MarcFinns/Active-Crossover-2025/Pictures/IMG_0705.jpeg

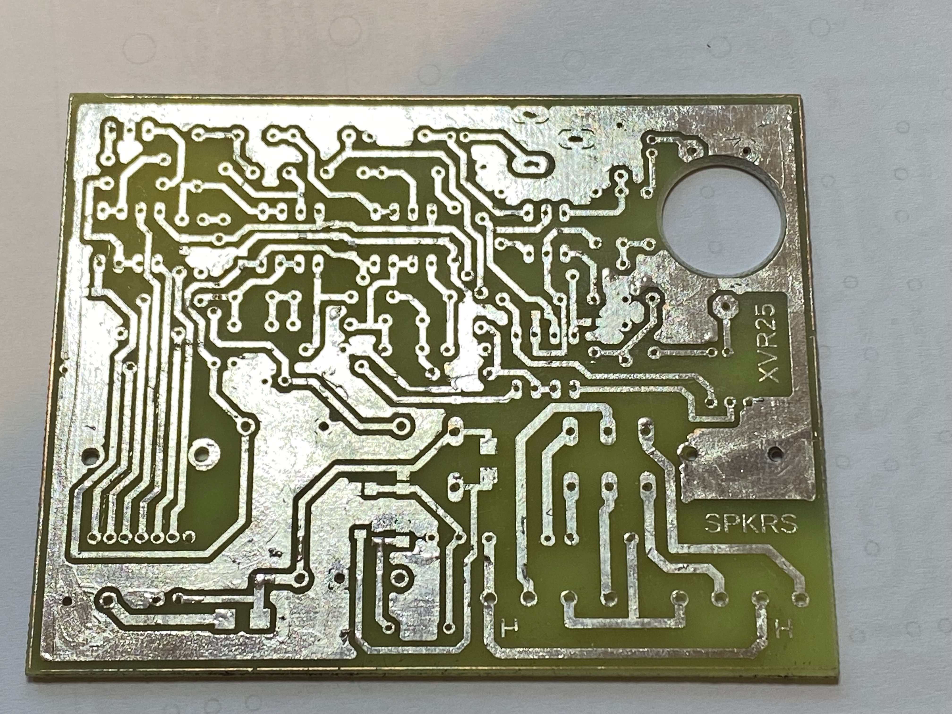
Pictures/IMG_0705.jpeg
