MarcFinns/Active-Crossover-2025/Pictures/IMG_1233.jpeg

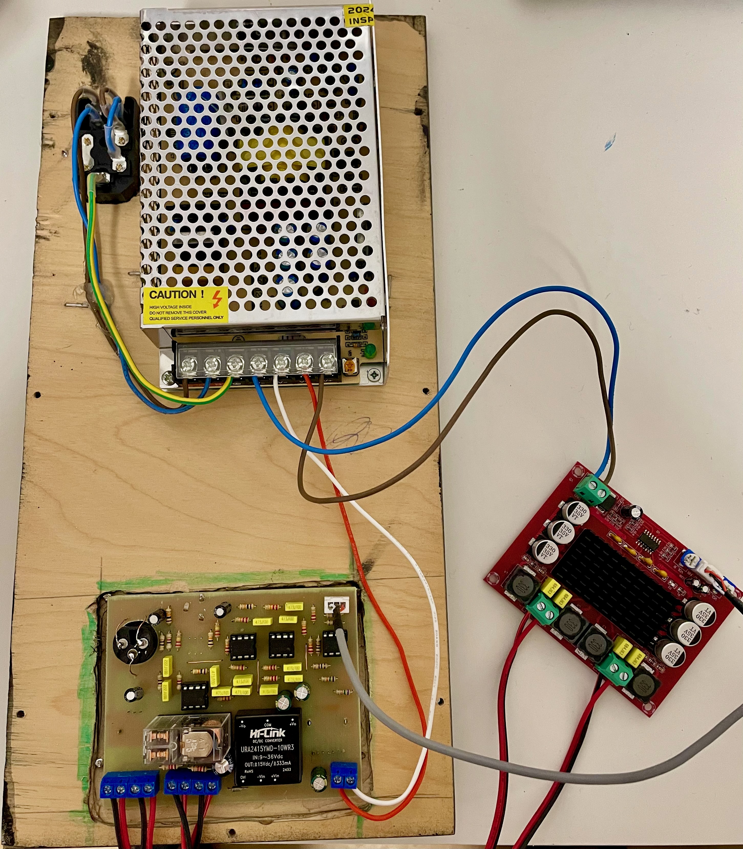
Pictures/IMG_1233.jpeg
