MarcFinns/Active-Crossover-2025/README.md

## Active crossover and anti-pop

Used to transform old speakers into active monitors together with a TPA3116 stereo amp board and a 24V power supply from Aliexpress
