MarcFinns/Active-Crossover-2025/Plate.pptx

LINE IN

XLR IN

100 W BI-AMP

INPUT SELECT

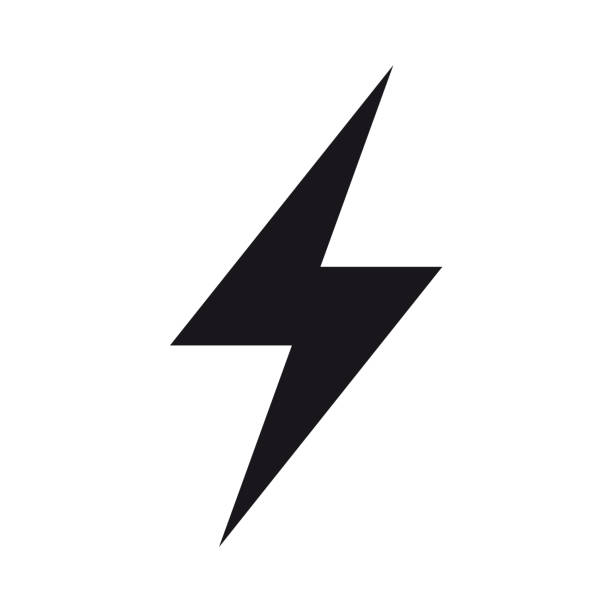
[picture p3: figure]
22,200+ Lightning Logo Stock Illustrations, Royalty-Free ...

LO

HI

VOLUME

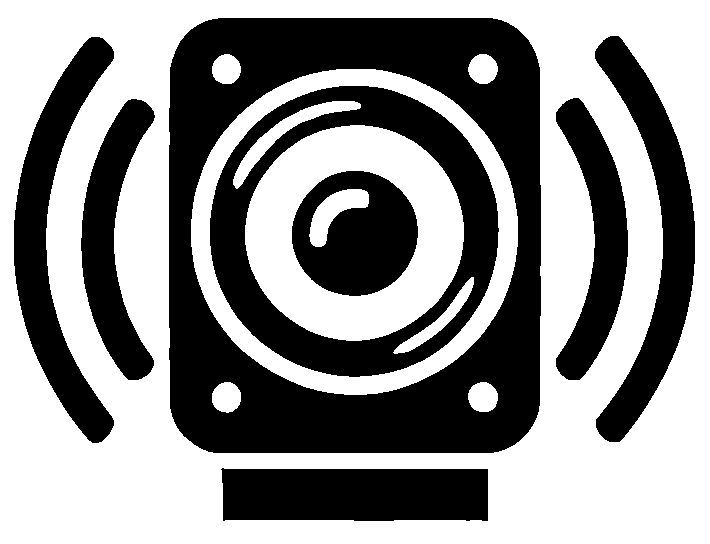
[picture p4: figure]

## Slide 2

100 W BI-AMP

LINE IN

XLR IN

INPUT SELECT

LO

HI

VOLUME
