MarcFinns/Active-Crossover-2025/Pictures/IMG_0700.jpeg

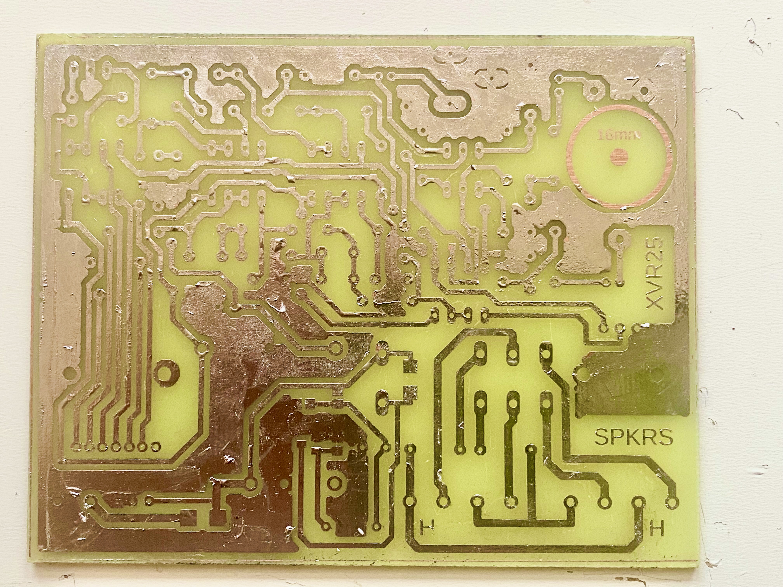
Pictures/IMG_0700.jpeg
