MarcFinns/Active-Crossover-2025/Pictures/IMG_0706.jpeg

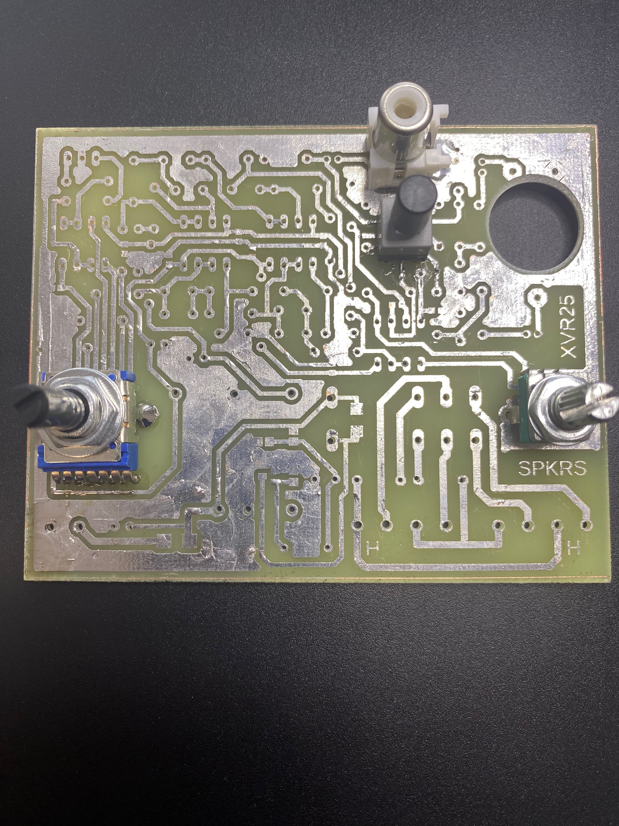
Pictures/IMG_0706.jpeg
