MarcFinns/Active-Crossover-2025/Pictures/IMG_0707.jpeg

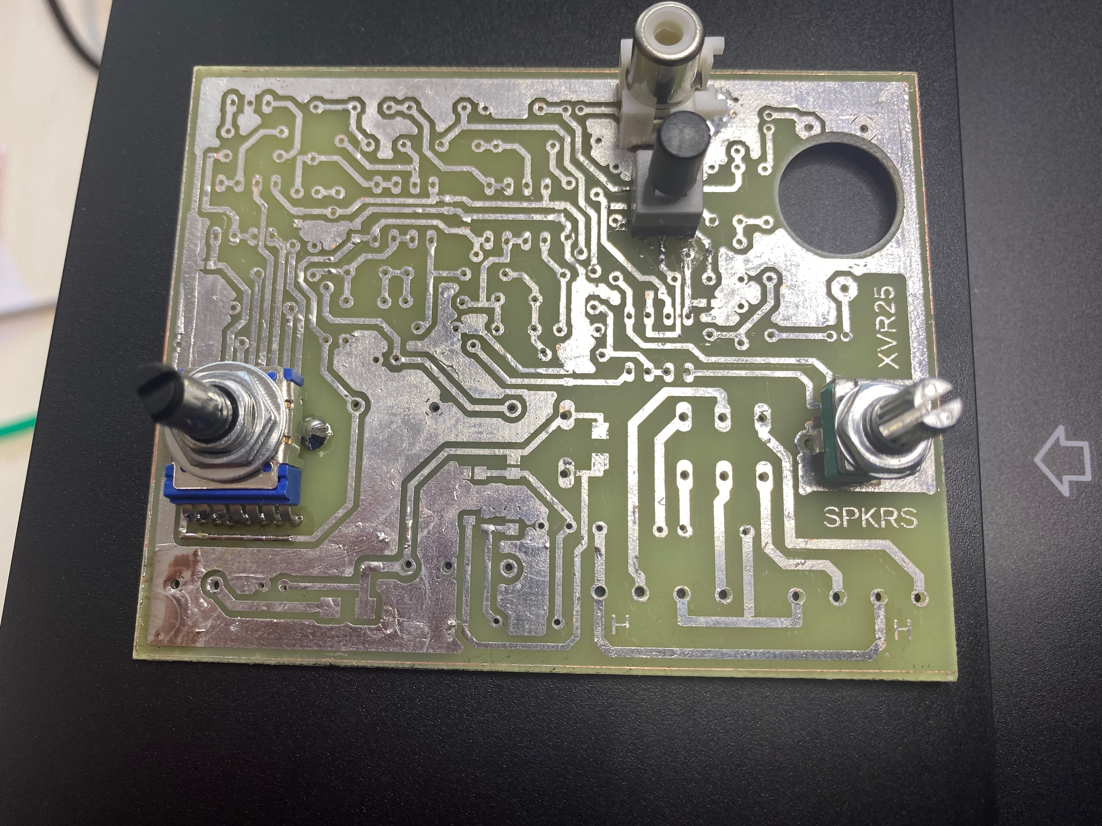
Pictures/IMG_0707.jpeg
