MarcFinns/Active-Crossover-2025/Pictures/IMG_0741.jpeg

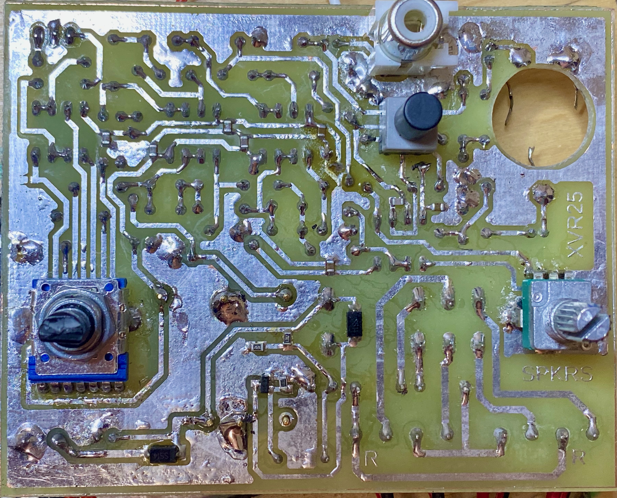
Pictures/IMG_0741.jpeg
