MarcFinns/Active-Crossover-2025/Pictures/IMG_0742.jpeg

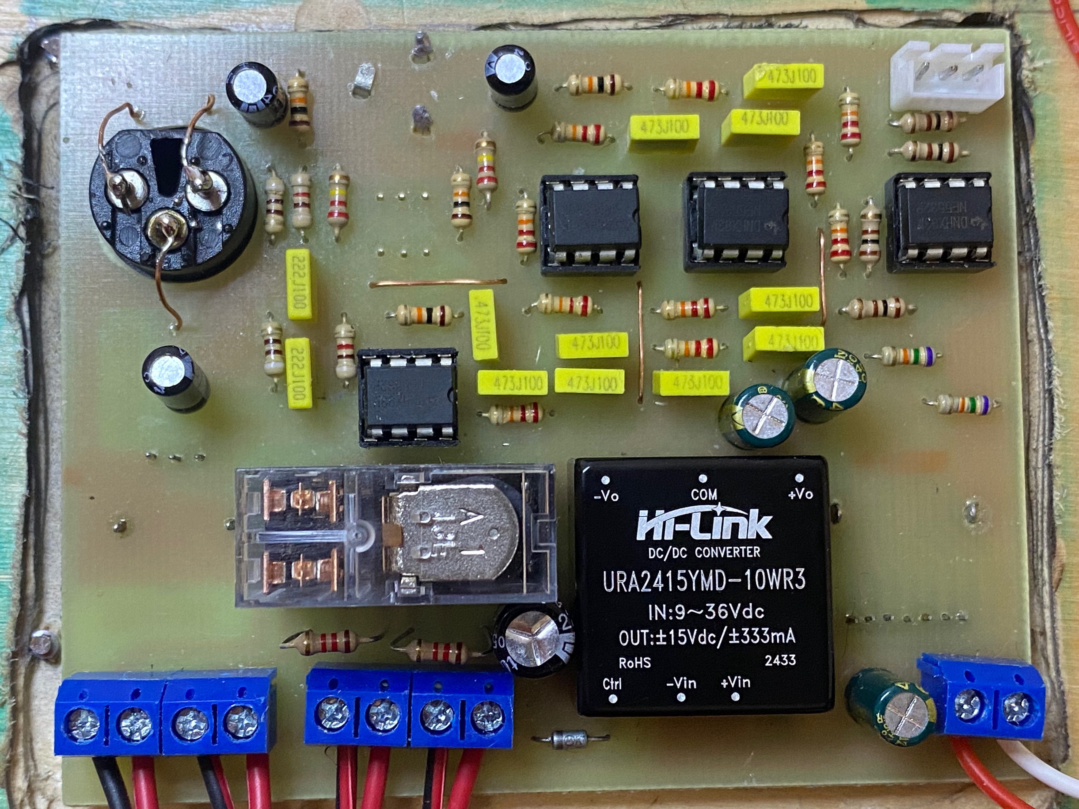
Pictures/IMG_0742.jpeg
