MarcFinns/Active-Crossover-2025/Pictures/IMG_1224.jpeg

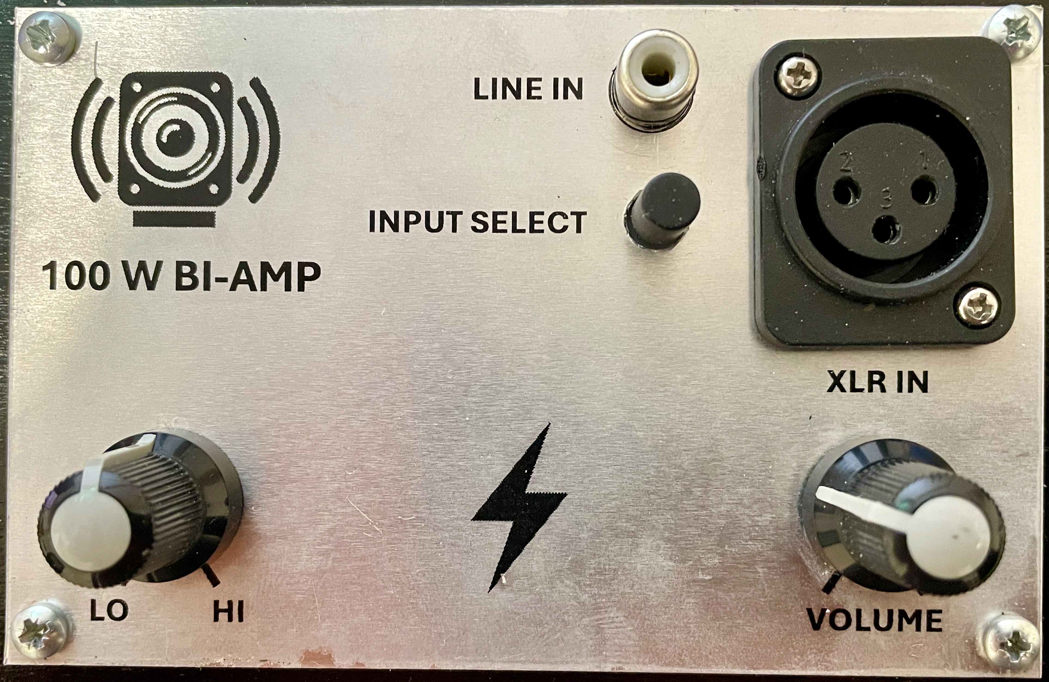
Pictures/IMG_1224.jpeg
