MarcFinns/Active-Crossover-2025/Pictures/IMG_1226.jpeg

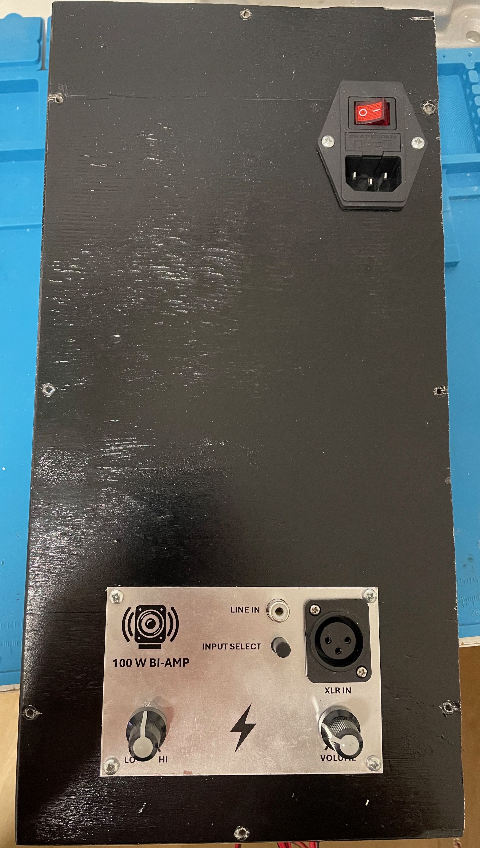
Pictures/IMG_1226.jpeg
