MarcFinns/Active-Crossover-2025/Pictures/IMG_1228.jpeg

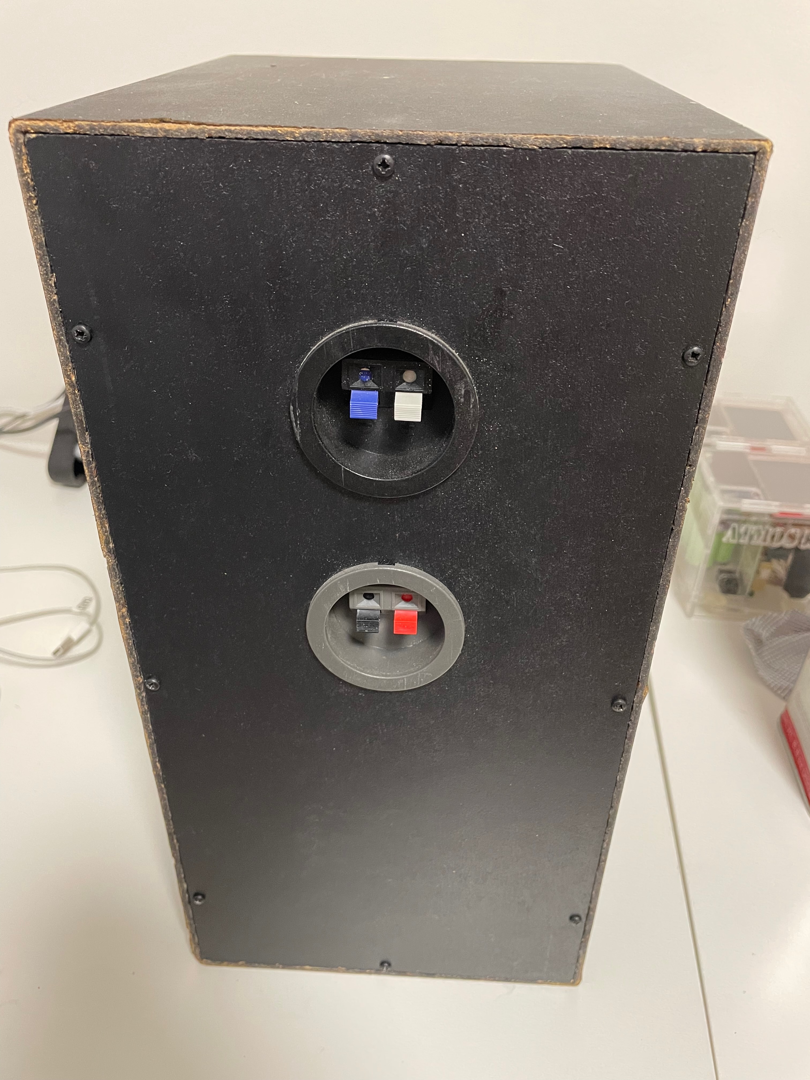
Pictures/IMG_1228.jpeg
