MarcFinns/Active-Crossover-2025/Pictures/IMG_1229.jpeg

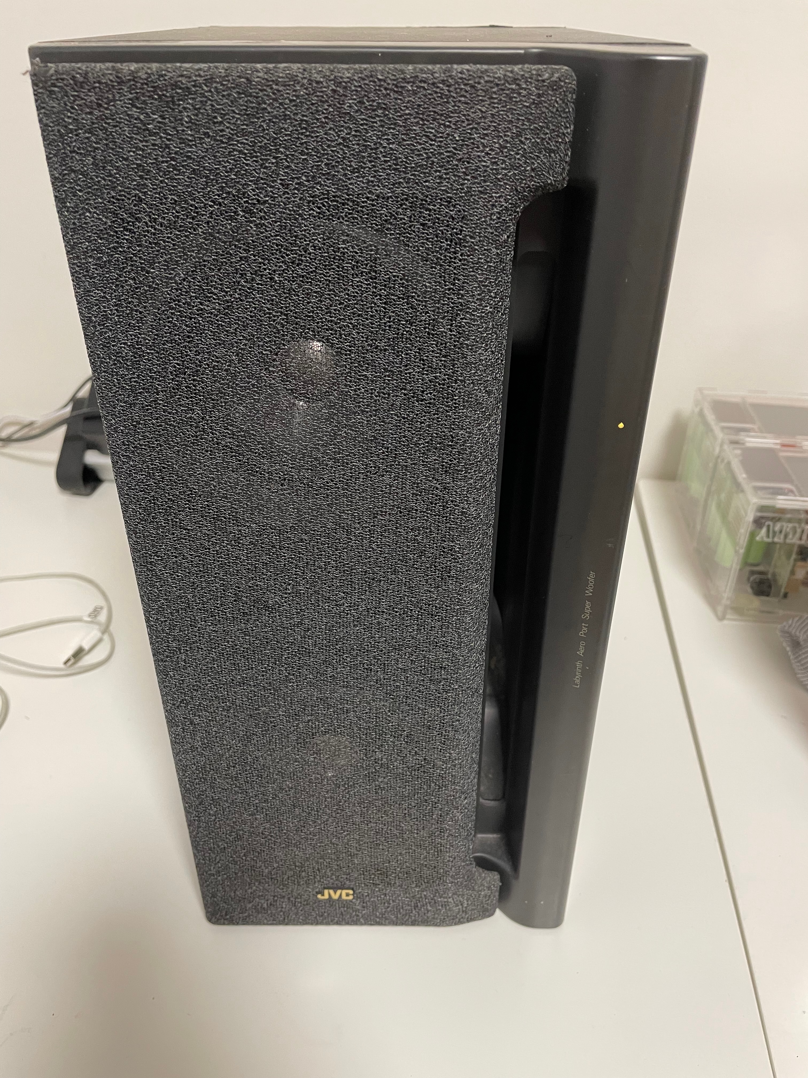
Pictures/IMG_1229.jpeg
