MarcFinns/Active-Crossover-2025/Pictures/IMG_1230.jpeg

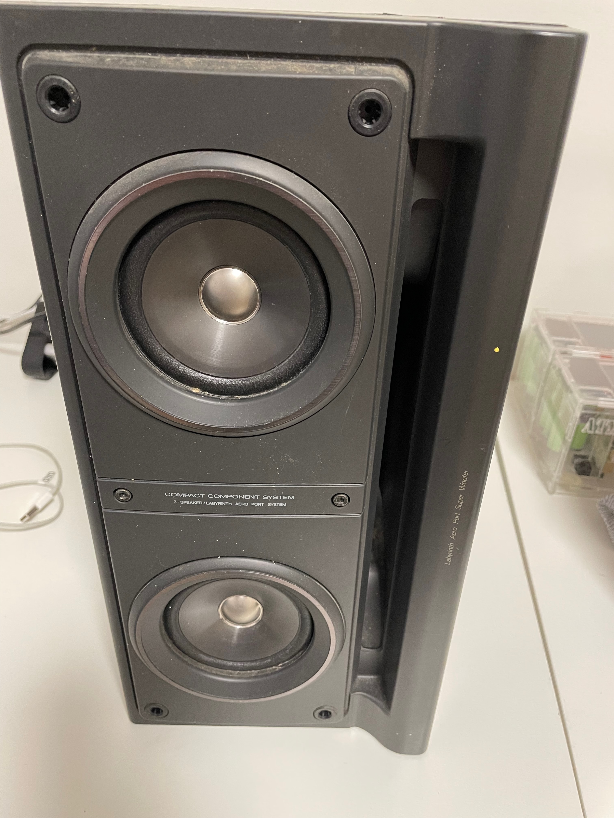
Pictures/IMG_1230.jpeg
