MarcFinns/Active-Crossover-2025/Pictures/IMG_1231.jpeg

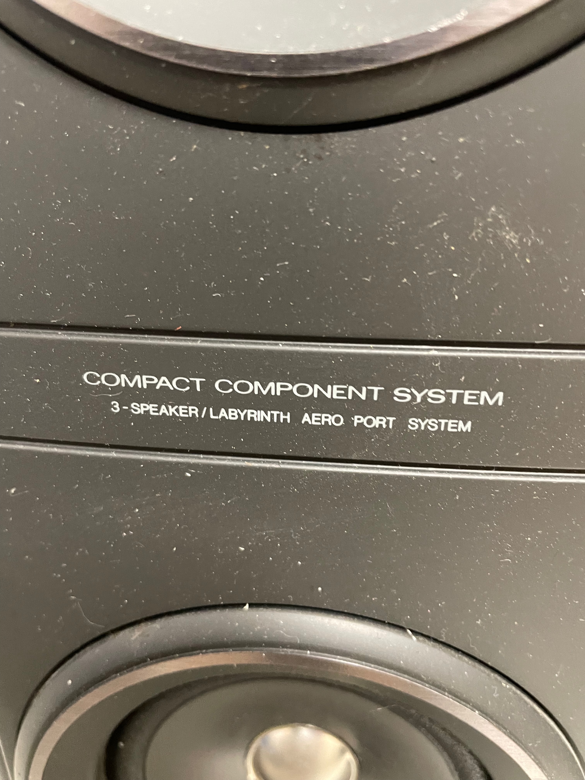
Pictures/IMG_1231.jpeg
