MarcFinns/Active-Crossover-2025/Pictures/IMG_1232.jpeg

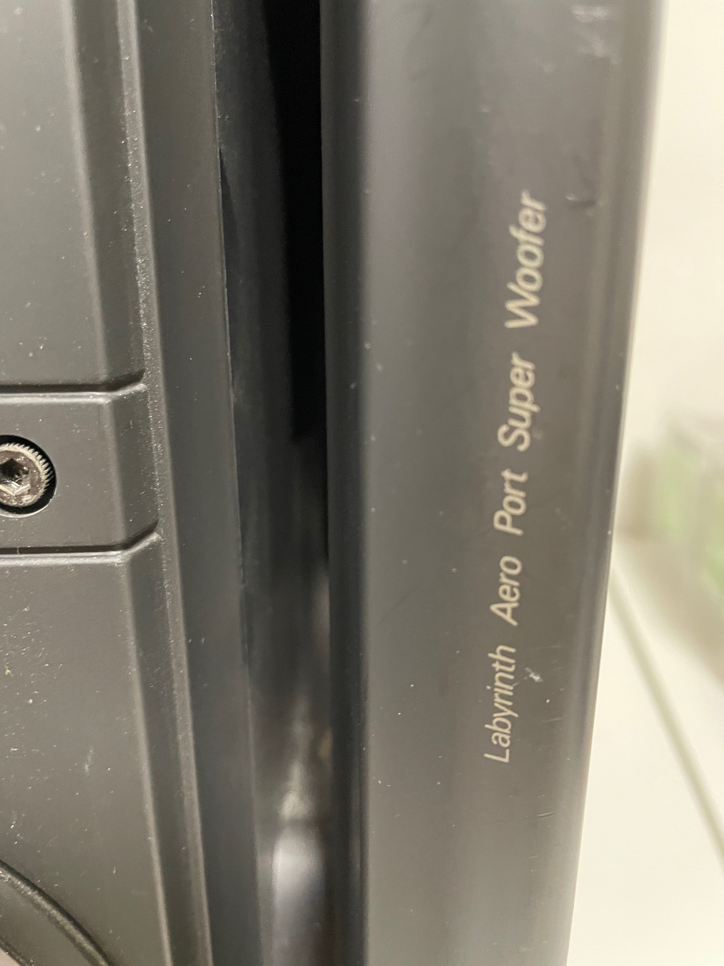
Pictures/IMG_1232.jpeg
