MarcFinns/Active-Crossover-2025/Component view.pdf

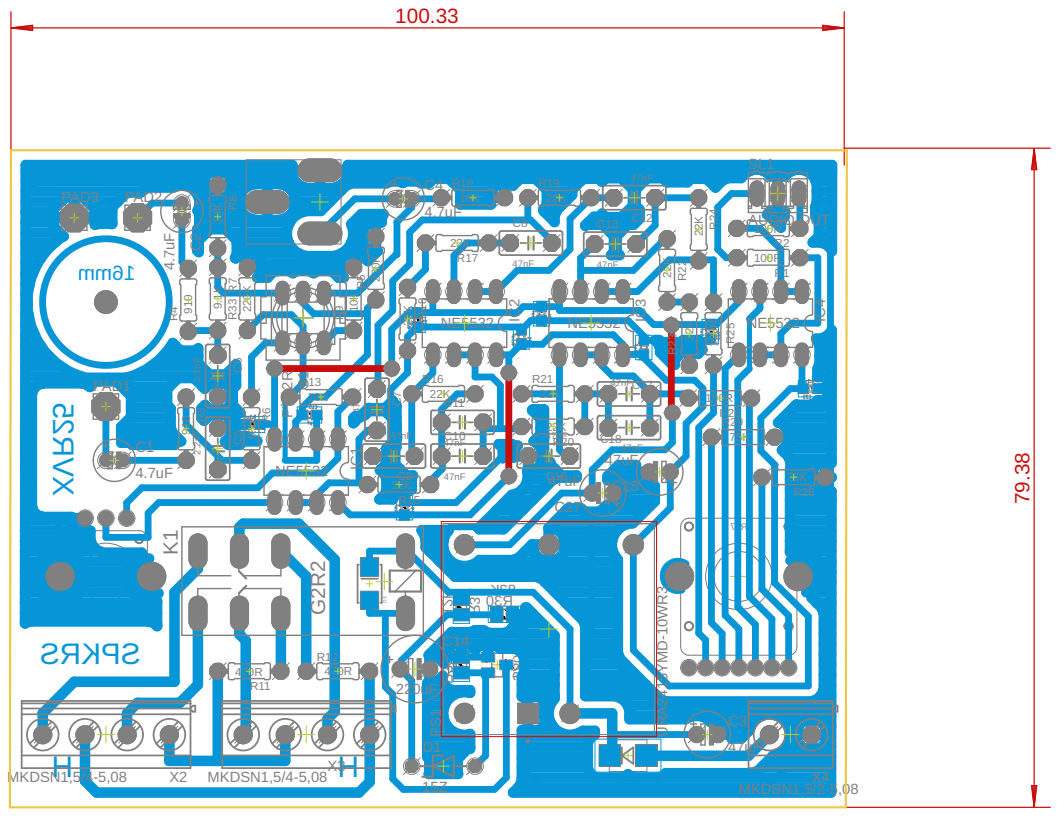
[picture p17: page 1]
