MarcFinns/Active-Crossover-2025/Schematic.pdf

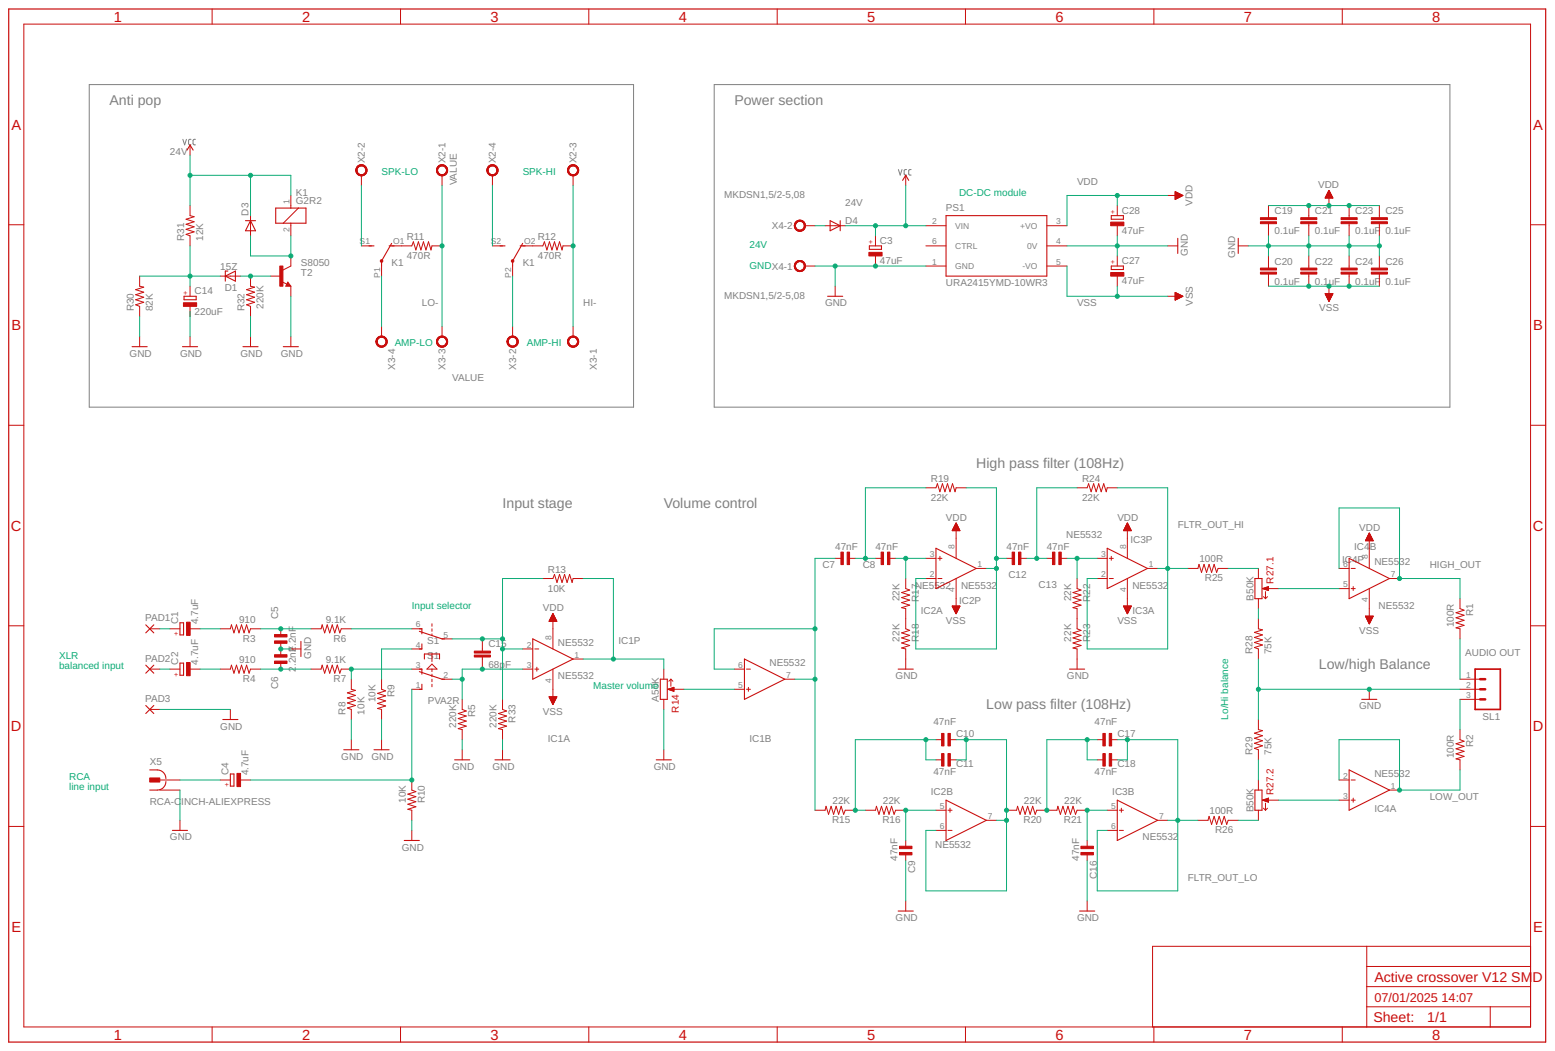
[picture p18: page 1]
