MarcFinns/Active-Crossover-2025/Bottom.pdf

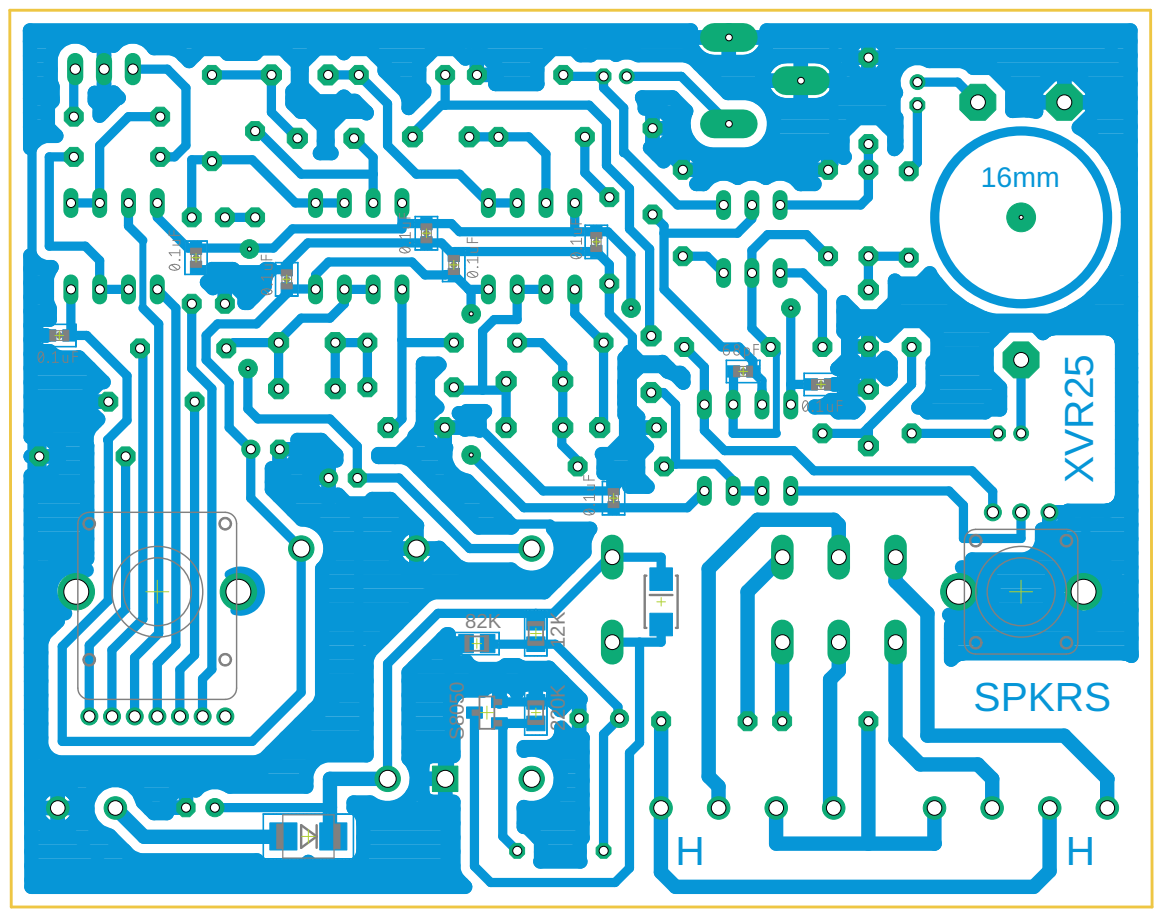
[picture p19: page 1]
