MarcFinns/Active-Crossover-2025/Top Layer.pdf

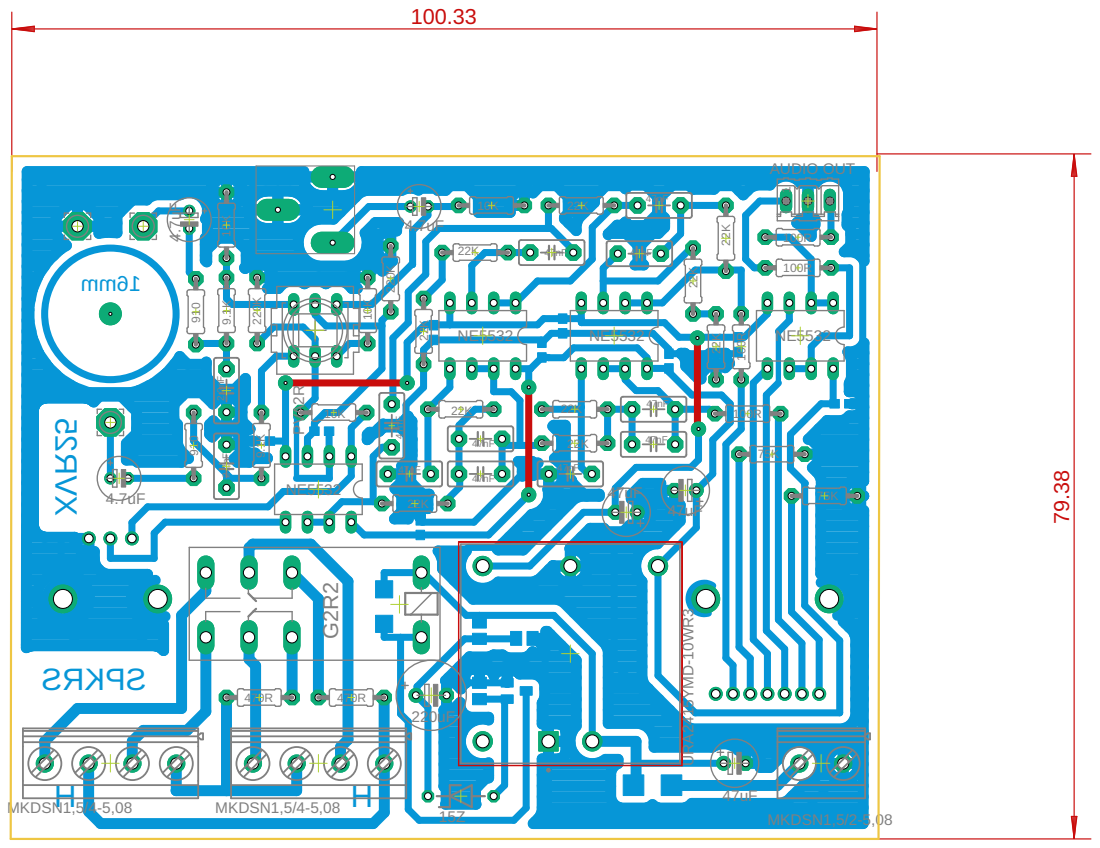
[picture p20: page 1]
