MarcFinns/Active-Crossover-2025/PCB bottom.pdf

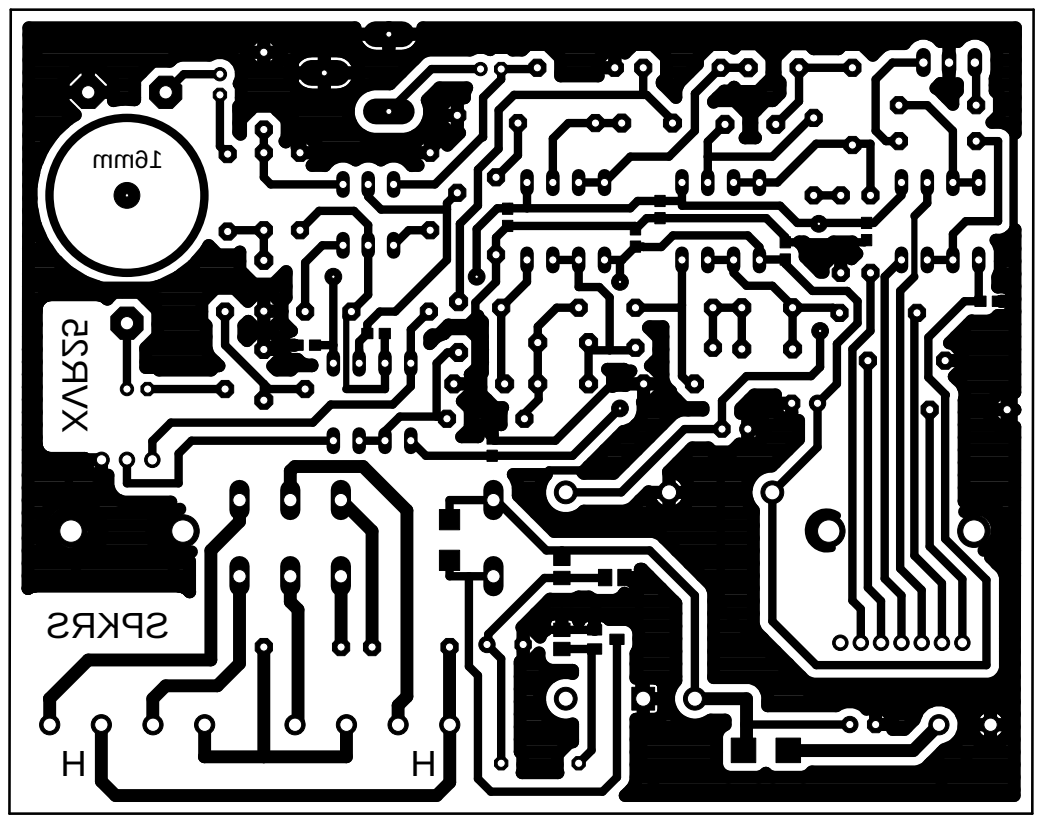
[picture p21: page 1]
