MarcFinns/Active-Crossover-2025/Active crossover V12 SMD.brd

## EAGLE design Active crossover V12 SMD.brd (2025-01-24)

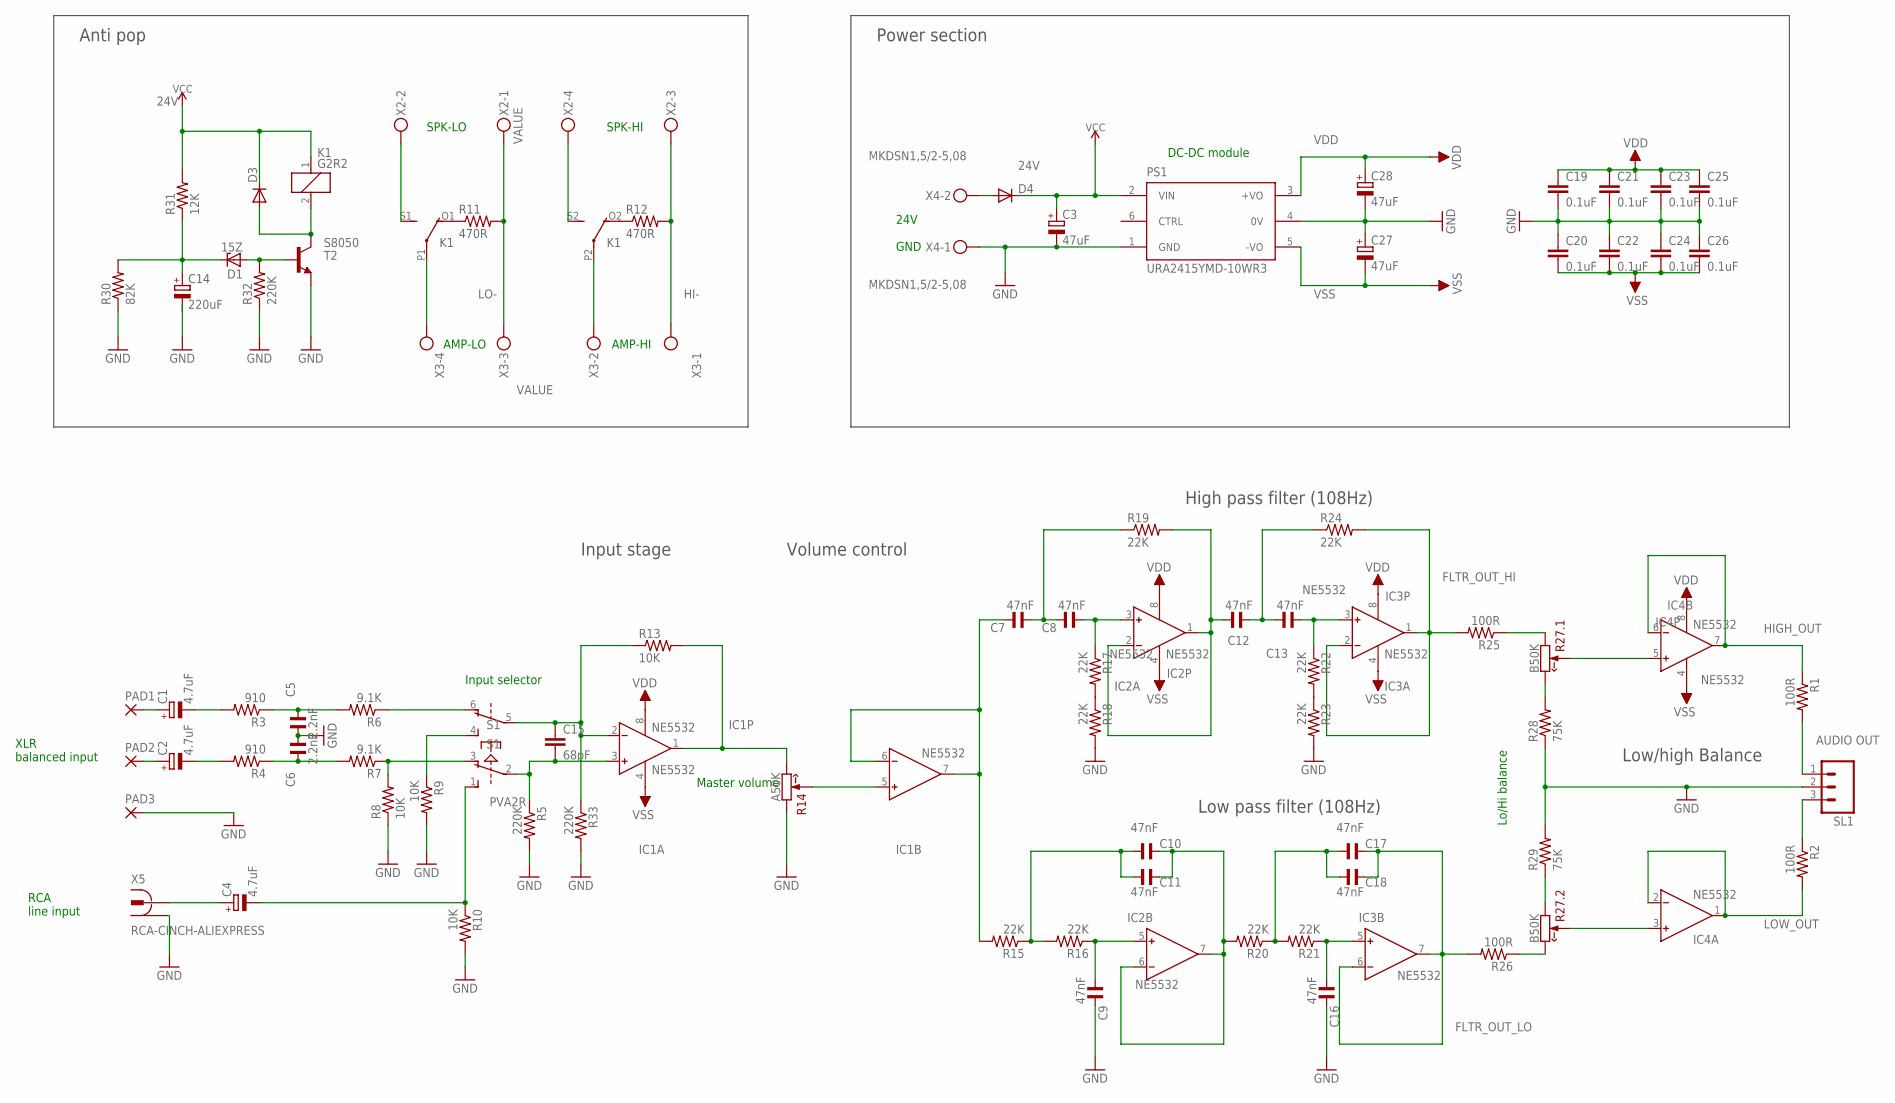
[picture p22: schematic Active crossover V12 SMD.sch]

Parts:
C1, C2, C4: 4.7uF; E2-5
C3, C27, C28: 47uF; E2,5-6
C5, C6: 2.2nF; C050-025X072
C7, C8, C9, C10, C11, C12, C13, C16, C17, C18: 47nF; C050-025X072
C14: 220uF; E3,5-8
C15: 68pF; 0603-CAP
C19, C20, C21, C22, C23, C24, C25, C26: 0.1uF; 0603-CAP
D1: 15Z; ZDIO-7.5
D3: DIODESMA-ALT; SMA-DIODE_ALT
D4: DIODESMB; SMB-DIODE
IC1, IC2, IC3, IC4: NE5532; DIL08
K1: G2R2
PAD1, PAD2, PAD3: 3,17/1,3
PS1: URA2415YMD-10WR3; CONV_URA2405YMD-10WR3
R1, R2, R25, R26: 100R; 0204/7
R3, R4: 910; 0204/7
R5, R33: 220K; 0204/7
R6, R7: 9.1K; 0204/7
R8, R9, R10, R13: 10K; 0204/7
R11, R12: 470R; 0204/7
R14: A50K; RV09-SINGLE
R15, R16, R17, R18, R19, R20, R21, R22, R23, R24: 22K; 0204/7
R27: B50K; RK14-DUAL
R28, R29: 75K; 0204/7
R30: 82K; M0805
R31: 12K; M0805
R32: 220K; M0805
S1: PVA2R
SL1: AUDIO OUT; 03P
T2: S8050; SOT23
X2, X3: MKDSN1,5/4-5,08
X4: MKDSN1,5/2-5,08
X5: RCA-CINCH-ALIEXPRESS

Connections:
24V: C3.+, D3.C, D4.C, K1.1, PS1.2 (VIN), R31.2
FLTR_OUT_HI: IC3.1 (OUT), IC3.2 (IN-), R24.2, R25.2
FLTR_OUT_LO: C17.2, C18.2, IC3.6 (IN-), IC3.7 (OUT), R26.2
GND: C3.-, C5.1, C6.2, C9.2, C14.-, C16.2, C19.2, C20.1, C21.2, C22.1, C23.2, C24.1, C25.2, C26.1, C27.+, C28.-, PAD3.1, PS1.1 (GND), PS1.4 (0V), R5.2, R8.1, R9.2, R10.2, R14.1 (CCW), R18.2, R23.2, R28.1, R29.2, R30.1, R32.1, R33.2, SL1.2, T2.2 (E), X4.1, X5.P$1 (1), X5.P$3 (1)
HI-: R12.2, X2.3, X3.1
HIGH_OUT: IC4.6 (IN-), IC4.7 (OUT), R1.1
LO-: R11.2, X2.1, X3.3
LOW_OUT: IC4.1 (OUT), IC4.2 (IN-), R2.2
unnamed: C1.+, PAD1.1
unnamed: C1.-, R3.2
unnamed: R7.1, R8.2, S1.3 (O)
unnamed: C15.1, IC1.2 (IN-), R13.1, R33.1, S1.5
unnamed: C15.2, IC1.3 (IN+), R5.1, S1.2
unnamed: C4.-, R10.1, S1.1 (S)
unnamed: R6.1, S1.6 (O)
unnamed: R9.1, S1.4 (S)
unnamed: IC1.1 (OUT), R13.2, R14.3 (CW)
unnamed: C14.+, D1.C, R30.2, R31.1
unnamed: K1.P1, X3.4
unnamed: D1.A, R32.2, T2.1 (B)
unnamed: D3.A, K1.2, T2.3 (C)
unnamed: IC1.5 (IN+), R14.2 (W)
unnamed: K1.S1 (S), X2.2
unnamed: C16.1, IC3.5 (IN+), R21.1
unnamed: C5.2, R3.1, R6.2
unnamed: C6.1, R4.1, R7.2
unnamed: C10.1, C11.1, R15.1, R16.2
unnamed: C17.1, C18.1, R20.1, R21.2
unnamed: C8.1, IC2.3 (IN+), R17.1
unnamed: C7.1, C8.2, R19.1
unnamed: R27.3 (CCW), R29.1
unnamed: C9.1, IC2.5 (IN+), R16.1
unnamed: R27.1' (CW), R28.2
unnamed: C12.2, IC2.1 (OUT), IC2.2 (IN-), R19.2
unnamed: C12.1, C13.2, R24.1
unnamed: C13.1, IC3.3 (IN+), R22.1
unnamed: C10.2, C11.2, IC2.6 (IN-), IC2.7 (OUT), R20.2
unnamed: K1.O1 (O), R11.1
unnamed: K1.P2, X3.2
unnamed: K1.S2 (S), X2.4
unnamed: K1.O2 (O), R12.1
unnamed: R17.2, R18.1
unnamed: C7.2, IC1.6 (IN-), IC1.7 (OUT), R15.2
unnamed: R22.2, R23.1
unnamed: R25.1, R27.3' (CCW)
unnamed: IC4.5 (IN+), R27.2' (W)
unnamed: IC4.3 (IN+), R27.2 (W)
unnamed: R26.1, R27.1 (CW)
unnamed: C2.+, PAD2.1
unnamed: C2.-, R4.2
unnamed: C4.+, X5.P$2 (2)
unnamed: D4.A, X4.2
unnamed: R1.2, SL1.1
unnamed: R2.1, SL1.3
VDD: C19.1, C21.1, C23.1, C25.1, C28.+, IC1.8 (V+), IC2.8 (V+), IC3.8 (V+), IC4.8 (V+), PS1.3 (+VO)
VSS: C20.2, C22.2, C24.2, C26.2, C27.-, IC1.4 (V-), IC2.4 (V-), IC3.4 (V-), IC4.4 (V-), PS1.5 (-VO)

Notes on the sheet:
XLR balanced input
RCA line input
Input selector
Master volume
AMP-LO
AMP-HI
SPK-LO
SPK-HI
24V GND
DC-DC module
Lo/Hi balance
Anti pop
Power section
Input stage
Volume control
High pass filter (108Hz)
Low pass filter (108Hz)
Low/high Balance

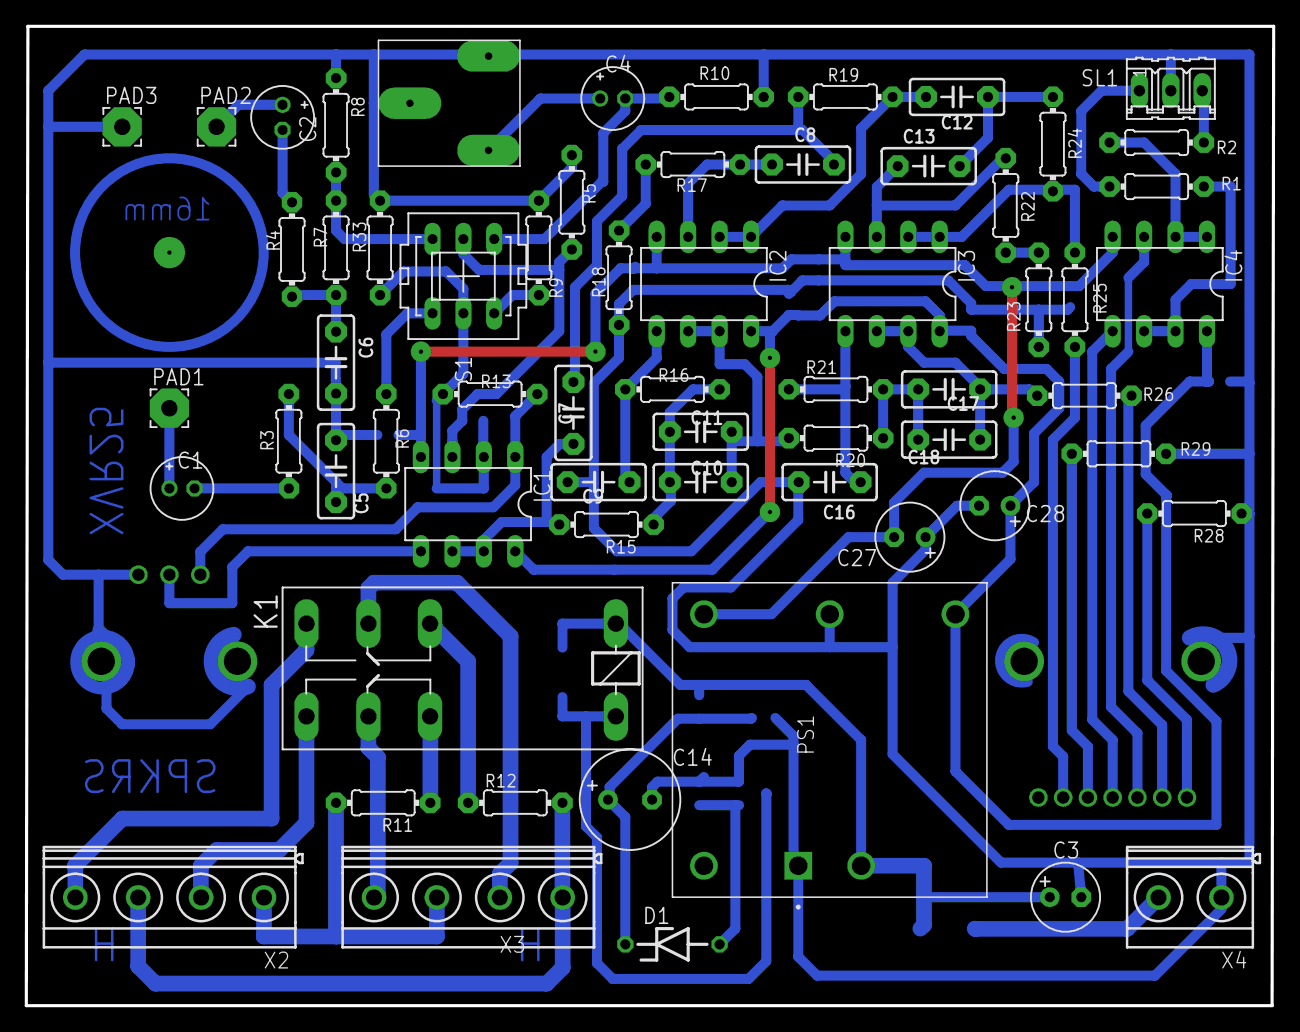
[picture p23: board Active crossover V12 SMD.brd from above]

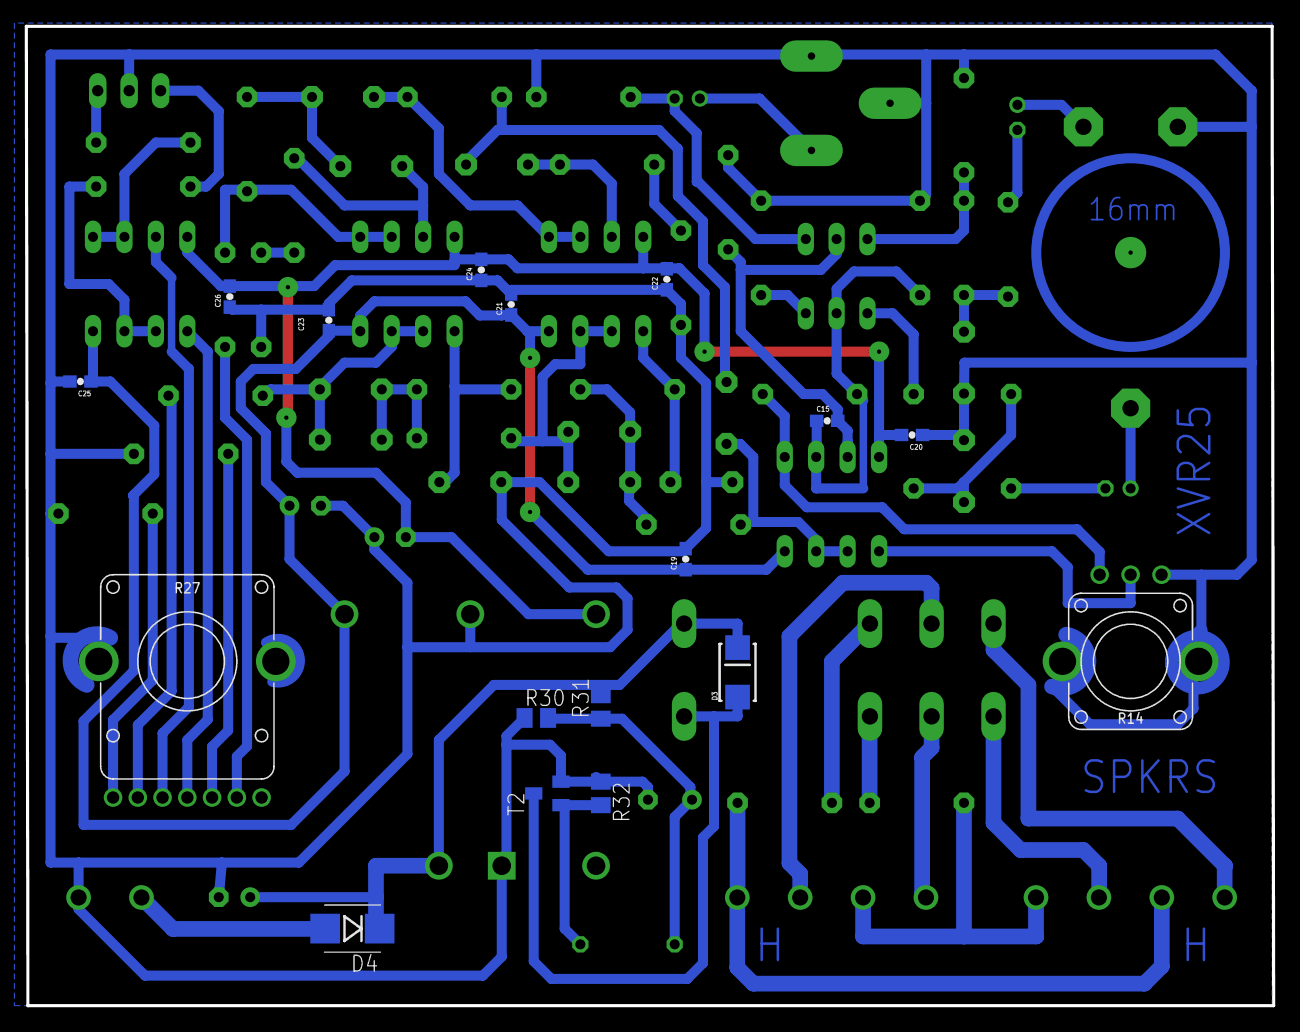
[picture p24: board Active crossover V12 SMD.brd from below]

Board: 2 copper layers, 100.8 x 79.1 mm, 80 parts (17 on the bottom side), 56 nets.
