MarcFinns/Active-Crossover-2025/(notices)

Notices in the files:
parts and their libraries:
cap-wima: Copyright (C) 2010, Bob Starr
SparkFun-Capacitors: Licensing: CC v3.0 Share-Alike You are welcome to use this library for commercial purposes.
supply4: Copyright (C) 2007, Bob Starr
